sadekbaroudi/KLOR/case/README.md

# KLOR CASE FILES

(Replaced by KS-27 case)

https://github.com/sadekbaroudi/keyboard-cases/tree/master/KLOR
