sadekbaroudi/KLOR/knob/README.md

# KLOR KNOB

The original knob provided by GEIST will not fit into the KS-27 case. You can use any knob that is 15mm in diameter. I (sadek) have a collection of 3D printable knobs you can print here:
https://github.com/sadekbaroudi/fingerpunch/tree/master/3d-models/ec11-knobs/D
