sadekbaroudi/KLOR/PCB/README.md

# KLOR PCB FILES

## Sadek KS-27 mod

**Please note: This is a modded version of the KLOR using soldered KS-27 switches instead of MX hotswap. I also removed the trackball support in the process to simplify routing**

Everything below is the original README for the KLOR.

## MANUFACTURING
If you want to get the PCB made you need to download the [ZIP](/PCB/klor1_3/KLOR_1-3_gerbers.zip/) and upload it to the website of the manufacture ([JLCPCB](https://jlcpcb.com/) or [PCBway](https://www.pcbway.com/) for example).

- download [the ZIP file](/PCB/klor1_3/KLOR_1-3_gerbers.zip/)
- upload the ZIP file
- sometimes the Gerber preview from JLCPCB can't display the PCB, even when the files are fine. In this case use this dimensions: 159.8 mm* 118 mm
- PCB Thickness 1.6mm
- 2 layers
- PCB Qty as much as you like. But be aware, that you need 2 PCBs for one keyboard
- PCB Color Black
- No impedance control
- Surface Finish HASL(with lead) if you want the easiest soldering experience or LeadFree HASL.
- Remove Order Number Yes

KLOR pcb

## CHECK TRACES OR PINOUT

If you only want to check the traces or see what is connected to which pin you can take a look at these graphics.

KLOR pinout
KLOR traces
KLOR LED order

## TAKE A DEEPER LOOK OR MODIFY 

You can download the project if you need to take a deeper look or modify something. You need the Open Source software [KiCad](https://www.kicad.org/) to open it.
