sadekbaroudi/KLOR/(commit log)

2022-11-27 modified KLOR to use KS-27 switches, and no longer supports the trackball
    [klor1_3-B_Mask.gbs, klor1_3-B_Paste.gbp, klor1_3-B_Silkscreen.gbo, klor1_3-Edge_Cuts.gm1, klor1_3-F_Mask.gts, klor1_3-F_Paste.gtp, klor1_3-F_Silkscreen.gto, klor1_3-NPTH-drl_map.gbr]
2022-12-07 added more notes, and link to case files
2022-12-08 added correct gerbers this time for KS-27
2022-12-21 fixed extra remaining traces that shorted A, D, and G keys
    [klor1_3-B_Mask.gbs, klor1_3-B_Paste.gbp, klor1_3-B_Silkscreen.gbo, klor1_3-Edge_Cuts.gm1, klor1_3-F_Mask.gts, klor1_3-F_Paste.gtp, klor1_3-F_Silkscreen.gto, klor1_3-NPTH-drl_map.gbr]
2022-12-21 removed files that aren't relevant for KS-27 version, and updated docs in general for this build
    [KLOR_konrad_3DP_switchplate.dxf, KLOR_konrad_3DP_switchplate.step, KLOR_konrad_3DP_switchplate.stl, KLOR_konrad_3DPcase_acrylic.dxf, KLOR_konrad_3DPcase_acrylic_logotype.dxf, KLOR_konrad_acrylic_case_switchplate.dxf, KLOR_konrad_acrylic_case_switchplate.step, KLOR_konrad_acrylic_case_switchplate.stl]
2023-02-14 added a choc version, untested
    [bom.csv, designators.csv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]
2023-02-14 KLOR choc v1 hotswap
    [bom.csv, designators.csv, klor1_3.kicad_sch, positions.csv]
2023-02-27 diodes were positioned too close to hotswap sockets, making it really hard to solder them, fixed
    [positions.csv]
